michalsc/FT2232_JTAG/FT2232_JTAG.kicad_pcb

## KiCad design FT2232_JTAG.kicad_pcb (2024-09-09)

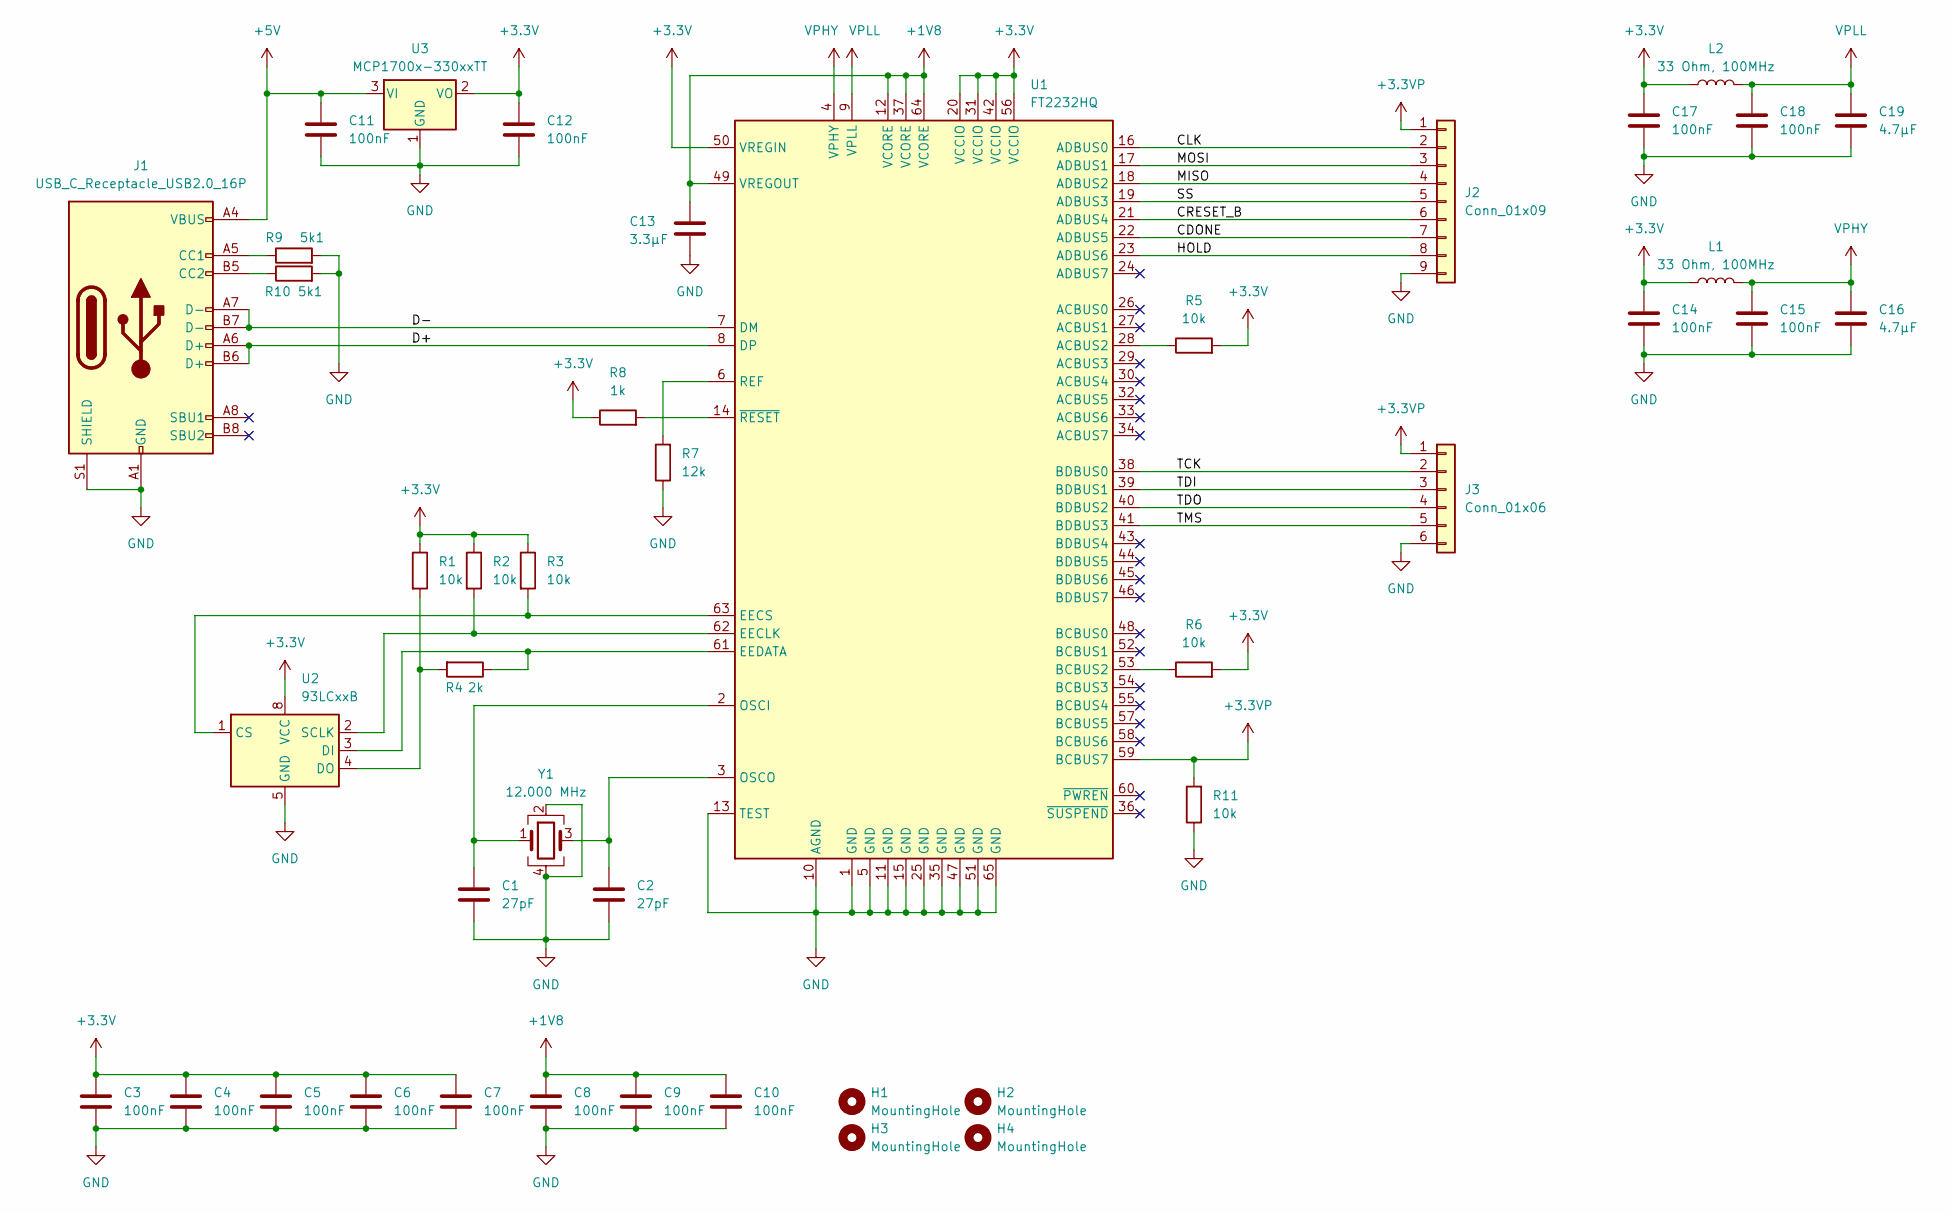
[picture p1: schematic FT2232_JTAG.kicad_sch]

Parts:
C1, C2: 27pF; C_0402_1005Metric; LCSC Part C1557
C3, C4, C5, C6, C7, C8, C9, C10, C11, C12, C14, C15, C17, C18: 100nF; C_0402_1005Metric; LCSC Part C3012376
C13: 3.3µF; C_0402_1005Metric; LCSC Part C695126
C16, C19: 4.7µF; C_0402_1005Metric; LCSC Part C76995
H1, H2, H3, H4: MountingHole; MountingHole_2.2mm_M2_ISO14580
J1: USB_C_Receptacle_USB2.0_16P; USB_C_Receptacle_GCT_USB4110; LCSC Part C5187472
J2: Conn_01x09; PinHeader_1x09_P2.00mm_Vertical
J3: Conn_01x06; PinHeader_1x06_P2.00mm_Vertical
L1, L2: 33 Ohm, 100MHz; L_0402_1005Metric; LCSC Part C160974
R1, R2, R3, R5, R6, R11: 10k; R_0402_1005Metric; LCSC Part C25531
R4: 2k; R_0402_1005Metric; LCSC Part C25552
R7: 12k; R_0402_1005Metric; LCSC Part C25752
R8: 1k; R_0402_1005Metric; LCSC Part C102758
R9, R10: 5k1; R_0402_1005Metric; LCSC Part C25941
U1: FT2232HQ; QFN-64-1EP_9x9mm_P0.5mm_EP4.35x4.35mm; LCSC Part C193662
U2: 93LCxxB; TSSOP-8_4.4x3mm_P0.65mm; LCSC Part C616741
U3: MCP1700x-330xxTT; SOT-23; LCSC Part C5148688
Y1: 12.000 MHz; Crystal_SMD_3225-4Pin_3.2x2.5mm; LCSC Part C9002

Connections:
+1V8: C8.1, C9.1, C10.1, C13.1, U1.12 (VCORE), U1.37 (VCORE), U1.49 (VREGOUT), U1.64 (VCORE)
+3.3V: C3.1, C4.1, C5.1, C6.1, C7.1, C12.1, C14.1, C17.1, L1.1, L2.1, R1.1, R2.1, R3.1, R5.2, R6.2, R8.1, U1.20 (VCCIO), U1.31 (VCCIO), U1.42 (VCCIO), U1.50 (VREGIN), U1.56 (VCCIO), U2.8 (VCC), U3.2 (VO)
+3.3VP: J2.1, J3.1, R11.2, U1.59 (BCBUS7)
+5V: C11.1, J1.A4 (VBUS), J1.A9 (VBUS), J1.B4 (VBUS), J1.B9 (VBUS), U3.3 (VI)
/CDONE: J2.7, U1.22 (ADBUS5)
/CLK: J2.2, U1.16 (ADBUS0)
/CRESET_B: J2.6, U1.21 (ADBUS4)
/D+: J1.A6 (D+), J1.B6 (D+), U1.8 (DP)
/D-: J1.A7 (D-), J1.B7 (D-), U1.7 (DM)
/HOLD: J2.8, U1.23 (ADBUS6)
/MISO: J2.4, U1.18 (ADBUS2)
/MOSI: J2.3, U1.17 (ADBUS1)
/SS: J2.5, U1.19 (ADBUS3)
/TCK: J3.2, U1.38 (BDBUS0)
/TDI: J3.3, U1.39 (BDBUS1)
/TDO: J3.4, U1.40 (BDBUS2)
/TMS: J3.5, U1.41 (BDBUS3)
GND: C1.2, C2.2, C3.2, C4.2, C5.2, C6.2, C7.2, C8.2, C9.2, C10.2, C11.2, C12.2, C13.2, C14.2, C15.2, C16.2, C17.2, C18.2, C19.2, J1.A1 (GND), J1.A12 (GND), J1.B1 (GND), J1.B12 (GND), J1.S1 (SHIELD), J2.9, J3.6, R7.1, R9.2, R10.2, R11.1, U1.1 (GND), U1.5 (GND), U1.10 (AGND), U1.11 (GND), U1.13 (TEST), U1.15 (GND), U1.25 (GND), U1.35 (GND), U1.47 (GND), U1.51 (GND), U1.65 (GND), U2.5 (GND), U3.1 (GND), Y1.2, Y1.4
unnamed: J1.A5 (CC1), R9.1
unnamed: J1.B5 (CC2), R10.1
unnamed: R5.1, U1.28 (ACBUS2)
unnamed: R6.1, U1.53 (BCBUS2)
unnamed: R2.2, U1.62 (EECLK), U2.2 (SCLK)
unnamed: R3.2, U1.63 (EECS), U2.1 (CS)
unnamed: R4.1, U1.61 (EEDATA), U2.3 (DI)
unnamed: C1.1, U1.2 (OSCI), Y1.1
unnamed: C2.1, U1.3 (OSCO), Y1.3
unnamed: R7.2, U1.6 (REF)
unnamed: R8.2, U1.14 (~RESET)
unnamed: R1.2, R4.2, U2.4 (DO)
VPHY: C15.1, C16.1, L1.2, U1.4 (VPHY)
VPLL: C18.1, C19.1, L2.2, U1.9 (VPLL)

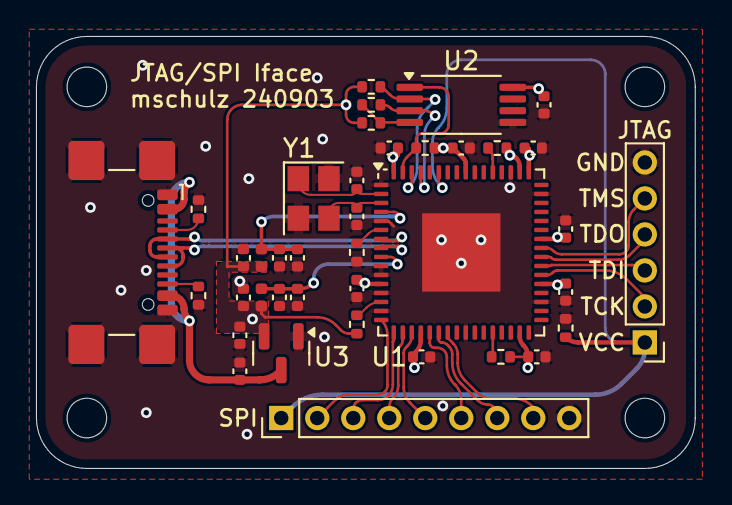
[picture p2: board FT2232_JTAG.kicad_pcb from above]

Board: 2 copper layers, 36.6 x 24.0 mm, 43 parts (0 on the bottom side), 32 nets.
