michalsc/FT2232_JTAG/(commit log)

2024-09-03 Fixed pull on BCBUS7
    [FT2232_JTAG.kicad_pcb, FT2232_JTAG.kicad_sch]
2024-09-03 Routing done. DRC ToDo.
    [FT2232_JTAG.kicad_pcb]
2024-09-09 added LCSC part numbers
    [FT2232_JTAG.kicad_sch]
